bokunimowakaru/ups/m5core/ups_controller/lib_analogMeter4log.ino

/***********************************************************************
メータ表示用ライブラリ lib_analogMeter.ino

・160 x 84 サイズのメータを横に2個並べて表示

関数名              内容                第1引数 第2引数 第3引数 第4引数
------------------------------------------------------------------------
analogMeterInit     メータ画面の初期化  単位    Meter名 最小値  最大値
analogMeterSetName  メータ名の変更      Meter名 －      －      －
analogMeterNeedle   メータの針を移動    値      移動ｔ  －      －

本ソースコードは下記からダウンロードし、一部、改変したものです。
https://github.com/m5stack/M5Stack/blob/master/examples/Advanced/Display/TFT_Meter_linear/TFT_Meter_linear.ino

ダウンロード日：2019/12/27

改変部の著作権は国野亘にあります。
配布は自由ですが権利情報の変更は不可。無保証。権利者は責任を負いません。
Copyright (c) 2019-2020 Wataru KUNINO
https://github.com/bokunimowakaru/m5s/blob/master/LICENSE
https://github.com/bokunimowakaru/m5adc/blob/master/LICENSE

筆者による改変部以外については、原作者（M5Stack社、Bodmer氏、Adafruit社）の
ライセンスにしたがってご利用下さい。

ライセンスに関する参考情報：
・https://github.com/m5stack/M5Stack/blob/master/LICENSE
    m5stack/M5Stack is licensed under the MIT License
・https://www.instructables.com/id/Arduino-TFT-display-and-font-library/
・https://github.com/Bodmer/TFT_eSPI/blob/master/license.txt
    Software License Agreement (FreeBSD License)
    Copyright (c) 2017 Bodmer (https://github.com/Bodmer)
・https://github.com/adafruit/Adafruit_ILI9341
    This is our library for the Adafruit  ILI9341 Breakout and Shield
    ----> http://www.adafruit.com/products/1651
    Check out the links above for our tutorials and wiring diagrams
    These displays use SPI to communicate, 4 or 5 pins are required to
    interface (RST is optional)
    Adafruit invests time and resources providing this open source code,
    please support Adafruit and open-source hardware by purchasing
    products from Adafruit!
    Written by Limor Fried/Ladyada for Adafruit Industries.
    MIT license, all text above must be included in any redistribution
*/

// Define meter size as 1 for M5.Lcd.rotation(0) or 1.3333 for M5.Lcd.rotation(1)
#define M_SIZE 0.6666

#define TFT_GREY 0x5AEB

String analogMeterUnit1="Celsius";
String analogMeterName1="Temp.";
String analogMeterUnit2="%RH";
String analogMeterName2="Humidity";
int analogMeterMinVal1 = 0;
int analogMeterMaxVal1 = 40;
int analogMeterMinVal2 = 0;
int analogMeterMaxVal2 = 100;

float ltx1 = 0;    // Saved x coord of bottom of needle
float ltx2 = 0;    // Saved x coord of bottom of needle
uint16_t osx1 = M_SIZE*120, osy1 = M_SIZE*120; // Saved x & y coords
uint16_t osx2 = M_SIZE*120, osy2 = M_SIZE*120; // Saved x & y coords
int old_analog1 =  -1; // Value last displayed
int old_analog2 =  -1; // Value last displayed
uint32_t updateTime = 0;       // time for next update
/*
int value[6] = {0, 0, 0, 0, 0, 0};
int old_value[6] = { -1, -1, -1, -1, -1, -1};
int d = 0;

void setup(void) {
  M5.begin();
  // M5.Lcd.setRotation(1);
  // Serial.begin(57600); // For debug
  M5.Lcd.fillScreen(TFT_BLACK);

  analogMeter(); // Draw analogue meter

  updateTime = millis(); // Next update time
}


void loop() {
  if (updateTime <= millis()) {
    updateTime = millis() + 35; // Update emter every 35 milliseconds
 
    // Create a Sine wave for testing
    d += 4; if (d >= 360) d = 0;
    value[0] = 50 + 50 * sin((d + 0) * 0.0174532925);
 
    plotNeedle(value[0], 0); // It takes between 2 and 12ms to replot the needle with zero delay
  }
}
*/

// #########################################################################
//  Draw the analogue meter on the screen
// #########################################################################
void analogMeterInit()
{
  M5.Lcd.setTextSize(1);

  // Meter outline (0,0) to (319,83) 320x84
  M5.Lcd.fillRect(2, 2, 156, 80, TFT_WHITE);
  M5.Lcd.fillRect(2+160, 2, 156, 80, TFT_WHITE);

  M5.Lcd.setTextColor(TFT_BLACK);  // Text colour

  // Draw ticks every 5 degrees from -50 to +50 degrees (100 deg. FSD swing)
  for (int i = -50; i < 51; i += 5) {
    // Long scale tick length
    int tl = 15;

    // Coodinates of tick to draw
    float sx = cos((i - 90) * 0.0174532925);
    float sy = sin((i - 90) * 0.0174532925);
    uint16_t x0 = sx * (M_SIZE*100 + tl) + M_SIZE*120;
    uint16_t y0 = sy * (M_SIZE*100 + tl) + M_SIZE*140;
    uint16_t x1 = sx * M_SIZE*100 + M_SIZE*120;
    uint16_t y1 = sy * M_SIZE*100 + M_SIZE*140;

    // Coordinates of next tick for zone fill
    float sx2 = cos((i + 5 - 90) * 0.0174532925);
    float sy2 = sin((i + 5 - 90) * 0.0174532925);
    int x2 = sx2 * (M_SIZE*100 + tl) + M_SIZE*120;
    int y2 = sy2 * (M_SIZE*100 + tl) + M_SIZE*140;
    int x3 = sx2 * M_SIZE*100 + M_SIZE*120;
    int y3 = sy2 * M_SIZE*100 + M_SIZE*140;

    // zone limits
    if (i >= -50 && i < -25) {
      M5.Lcd.fillTriangle(x0, y0, x1, y1, x2, y2, TFT_YELLOW);
      M5.Lcd.fillTriangle(x1, y1, x2, y2, x3, y3, TFT_YELLOW);
      M5.Lcd.fillTriangle(x0+160, y0, x1+160, y1, x2+160, y2, TFT_ORANGE);
      M5.Lcd.fillTriangle(x1+160, y1, x2+160, y2, x3+160, y3, TFT_ORANGE);
    }
    if (i >= -25 && i < 25) {
      M5.Lcd.fillTriangle(x0, y0, x1, y1, x2, y2, TFT_GREEN);
      M5.Lcd.fillTriangle(x1, y1, x2, y2, x3, y3, TFT_GREEN);
    }
    if (i >= 25 && i < 50) {
      M5.Lcd.fillTriangle(x0, y0, x1, y1, x2, y2, TFT_ORANGE);
      M5.Lcd.fillTriangle(x1, y1, x2, y2, x3, y3, TFT_ORANGE);
    }
    if (i >= 0 && i < 50) {
      M5.Lcd.fillTriangle(x0+160, y0, x1+160, y1, x2+160, y2, TFT_GREEN);
      M5.Lcd.fillTriangle(x1+160, y1, x2+160, y2, x3+160, y3, TFT_GREEN);
    }

    // Short scale tick length
    if (i % 25 != 0) tl = 8;

    // Recalculate coords incase tick lenght changed
    x0 = sx * (M_SIZE*100 + tl) + M_SIZE*120;
    y0 = sy * (M_SIZE*100 + tl) + M_SIZE*140;
    x1 = sx * M_SIZE*100 + M_SIZE*120;
    y1 = sy * M_SIZE*100 + M_SIZE*140;

    // Draw tick
    M5.Lcd.drawLine(x0, y0, x1, y1, TFT_BLACK);
    M5.Lcd.drawLine(x0+160, y0, x1+160, y1, TFT_BLACK);

    // Check if labels should be drawn, with position tweaks
    if (i % 25 == 0) {
      // Calculate label positions
      x0 = sx * (M_SIZE*100 + tl + 10) + M_SIZE*120;
      y0 = sy * (M_SIZE*100 + tl + 10) + M_SIZE*140;
      switch (i / 25) {
        case -2:
        	M5.Lcd.drawCentreString(String(analogMeterMinVal1), x0, y0 - 4, 1);
        	M5.Lcd.drawCentreString(String(analogMeterMinVal2), x0+160, y0 - 4, 1);
        	break;
        case -1:
        	M5.Lcd.drawCentreString(String((analogMeterMinVal1*3+analogMeterMaxVal1)/4), x0, y0 - 2, 1);
        	M5.Lcd.drawCentreString(String((analogMeterMinVal2*3+analogMeterMaxVal2)/4), x0+160, y0 - 2, 1);
        	break;
        case 0:
        	M5.Lcd.drawCentreString(String((analogMeterMinVal1+analogMeterMaxVal1)/2), x0, y0 + 2, 1);
        	M5.Lcd.drawCentreString(String((analogMeterMinVal2+analogMeterMaxVal2)/2), x0+160, y0 + 2, 1);
        	break;
        case 1:
        	M5.Lcd.drawCentreString(String((analogMeterMinVal1+analogMeterMaxVal1*3)/4), x0, y0 - 2, 1);
        	M5.Lcd.drawCentreString(String((analogMeterMinVal2+analogMeterMaxVal2*3)/4), x0+160, y0 - 2, 1);
        	break;
        case 2:
        	M5.Lcd.drawCentreString(String(analogMeterMaxVal1), x0, y0 - 4, 1);
        	M5.Lcd.drawCentreString(String(analogMeterMaxVal2), x0+160, y0 - 4, 1);
        	break;
      }
    }

    // Now draw the arc of the scale
    sx = cos((i + 5 - 90) * 0.0174532925);
    sy = sin((i + 5 - 90) * 0.0174532925);
    x0 = sx * M_SIZE*100 + M_SIZE*120;
    y0 = sy * M_SIZE*100 + M_SIZE*140;
    // Draw scale arc, don't draw the last part
    if (i < 50){
		M5.Lcd.drawLine(x0, y0, x1, y1, TFT_BLACK);
		M5.Lcd.drawLine(x0+160, y0, x1+160, y1, TFT_BLACK);
	}
  }


  M5.Lcd.drawRightString(analogMeterUnit1, M_SIZE*236, M_SIZE*109, 1); // Units at bottom right
  M5.Lcd.drawCentreString(analogMeterName1, M_SIZE*120, M_SIZE*70, 2); // Comment out to avoid font 4
  M5.Lcd.drawRect(1, 1, 158, 82, TFT_BLACK); // Draw bezel line
  M5.Lcd.drawRect(0, 0, 160, 84, TFT_GREY);
  
  M5.Lcd.drawRightString(analogMeterUnit2, M_SIZE*236+160, M_SIZE*109, 1); // Units at bottom right
  M5.Lcd.drawCentreString(analogMeterName2, M_SIZE*120+160, M_SIZE*70, 2); // Comment out to avoid font 4
  M5.Lcd.drawRect(1+160, 1, 158, 82, TFT_BLACK); // Draw bezel line
  M5.Lcd.drawRect(0+160, 0, 160, 84, TFT_GREY);

  analogMeterNeedle(0, 0.0); // Put meter needle at 0
  analogMeterNeedle(1, 0.0); // Put meter needle at 0
  M5.Lcd.setCursor(0,11*8);
}

void analogMeterInit(String unit_S1, int min_val1, int max_val1, String unit_S2, int min_val2, int max_val2){
  analogMeterUnit1 = unit_S1;
  analogMeterName1 = unit_S1;
  analogMeterMinVal1 = min_val1;
  analogMeterMaxVal1 = max_val1;
  analogMeterUnit2 = unit_S2;
  analogMeterName2 = unit_S2;
  analogMeterMinVal2 = min_val2;
  analogMeterMaxVal2 = max_val2;
  analogMeterInit();
}

void analogMeterInit(String unit_S1,String unit_S2){
  analogMeterUnit1 = unit_S1;
  analogMeterUnit2 = unit_S2;
  analogMeterInit();
}

void analogMeterSetName(int ch,String unit_S){
	if(ch==0){
		if(unit_S.length()>7) analogMeterName1 = unit_S.substring(0, 7);
		else analogMeterName1 = unit_S;
	}else if(ch==1){
		if(unit_S.length()>7) analogMeterName2 = unit_S.substring(0, 7);
		else analogMeterName2 = unit_S;
	}
}

void analogMeterSetNames(String unit_S1,String unit_S2){
  analogMeterSetName(0,unit_S1);
  analogMeterSetName(1,unit_S2);
}


// #########################################################################
// Update needle position
// This function is blocking while needle moves, time depends on ms_delay
// 10ms minimises needle flicker if text is drawn within needle sweep area
// Smaller values OK if text not in sweep area, zero for instant movement but
// does not look realistic... (note: 100 increments for full scale deflection)
// #########################################################################
void analogMeterNeedle(int ch, float value_fn, byte ms_delay)
{
  M5.Lcd.setTextColor(TFT_BLACK, TFT_WHITE);
  char buf[8];
  dtostrf(value_fn, 5, 1, buf);
  M5.Lcd.fillRect(3+ch*160, M_SIZE * 109, M_SIZE * 80, 8, TFT_WHITE);
  M5.Lcd.drawString(buf, M_SIZE*10+ch*160, M_SIZE*(109), 1);

  float value_f=0., delta=0., min=0., ltx=0.;
  uint16_t osx = M_SIZE*120, osy = M_SIZE*120;
  String analogMeterName;
  int old_analog;
  if(ch==0){
	value_f = value_fn;
	delta = (float)(analogMeterMaxVal1 - analogMeterMinVal1);
	min = analogMeterMinVal1;
	ltx = ltx1;
	osx = osx1;
	osy = osy1;
	old_analog = old_analog1;
	analogMeterName = analogMeterName1;
  }else if(ch==1){
	value_f = value_fn;
	delta = (float)(analogMeterMaxVal2 - analogMeterMinVal2);
	min = analogMeterMinVal2;
	ltx = ltx2;
	osx = osx2;
	osy = osy2;
	old_analog = old_analog2;
	analogMeterName = analogMeterName2;
  }else{
	return;
  }
  
  if( delta != 0.){
	value_f = ( value_f - min ) * 100 / delta;
  }
  int value;
  if(value_f > 0. ) value = (int)(value_f + 0.5);
  else              value = (int)(value_f - 0.5);

  if (value < -7) value = -7; // Limit value to emulate needle end stops
  if (value > 107) value = 107;

  // Move the needle until new value reached
  while (!(value == old_analog)) {
    if (old_analog < value) old_analog++;
    else old_analog--;

    if (ms_delay <= 0) old_analog = value; // Update immediately if delay is 0

    float sdeg = map(old_analog, -10, 110, -150, -30); // Map value to angle
    // Calcualte tip of needle coords
    float sx = cos(sdeg * 0.0174532925);
    float sy = sin(sdeg * 0.0174532925);

    // Calculate x delta of needle start (does not start at pivot point)
    float tx = tan((sdeg + 90) * 0.0174532925);

    // Erase old needle image
    M5.Lcd.drawLine(M_SIZE*(120 + 20 * ltx - 1) + ch * 160, M_SIZE*(140 - 20), osx - 1 + ch * 160, osy+1, TFT_WHITE);
    M5.Lcd.drawLine(M_SIZE*(120 + 20 * ltx) + ch * 160, M_SIZE*(140 - 20), osx + ch * 160, osy, TFT_WHITE);
    M5.Lcd.drawLine(M_SIZE*(120 + 20 * ltx + 1) + ch * 160, M_SIZE*(140 - 20), osx + 1 + ch * 160, osy+1, TFT_WHITE);

    // Re-plot text under needle
    M5.Lcd.setTextColor(TFT_BLACK);
    M5.Lcd.fillRect(M_SIZE*70 + ch * 160, M_SIZE*70, M_SIZE*100, 16,TFT_WHITE);
    M5.Lcd.drawCentreString(analogMeterName, M_SIZE*120 + ch * 160, M_SIZE*70, 2); // // Comment out to avoid font 4

    // Store new needle end coords for next erase
    ltx = tx;
    osx = M_SIZE*(sx * 98 + 120);
    osy = M_SIZE*(sy * 98 + 140);

    // Draw the needle in the new postion, magenta makes needle a bit bolder
    // draws 3 lines to thicken needle
    M5.Lcd.drawLine(M_SIZE*(120 + 20 * ltx - 1) + ch * 160, M_SIZE*(140 - 20), osx - 1 + ch * 160, osy+1, TFT_RED);
    M5.Lcd.drawLine(M_SIZE*(120 + 20 * ltx) + ch * 160, M_SIZE*(140 - 20), osx + ch * 160, osy, TFT_MAGENTA);
    M5.Lcd.drawLine(M_SIZE*(120 + 20 * ltx + 1) + ch * 160, M_SIZE*(140 - 20), osx + 1 + ch * 160, osy+1, TFT_RED);

    // Slow needle down slightly as it approaches new postion
    if (abs(old_analog - value) < 10) ms_delay += ms_delay / 5;

    // Wait before next update
    delay(ms_delay);
  }
  if(ch==0){
	ltx1 = ltx;
	osx1 = osx;
	osy1 = osy;
	old_analog1 = old_analog;
  }else if(ch==1){
	ltx2 = ltx;
	osx2 = osx;
	osy2 = osy;
	old_analog2 = old_analog;
  }
  M5.Lcd.setTextColor(TFT_WHITE);
}

void analogMeterNeedle(int ch, float value_fn){
	analogMeterNeedle(ch, value_fn, 35);
}
