bokunimowakaru/ups/(commit log)

2023-09-10 git add pictures/schematic_m5stack.png
2023-09-10 added for esp32c3
2023-09-10 fixed fet contorol
2023-09-11 take care of vf in diode and vds at fet
2023-09-14 measured v used for current direction
2023-09-15 Added Current Limit
2023-09-15 fixed bug in FET controller
    [ups_controller.ino]
2023-09-16 modified algo collesponding to voltage
2023-09-18 disabled fet switching during vlotage measuring
2023-09-23 solved UPS failure problem
    [ups_controller.ino]
2023-09-27 keeping low battery failure; not to recover
    [ups_controller.ino]
2023-09-27 for ESP32
2023-09-27 dont use low volt. batt
2024-12-12 RGB LEDの無効化機能追加
2024-12-12 RGB LEDに関する注意喚起
2024-12-12 ESP32C3のみ
2024-12-15 コメント追加およびRGB LED無効化
2024-12-17 reactive RGB LED
2024-12-17 for ESP32 / Atom
